Browilis/Arduino-Interactive-IO-Project-/(commit log)

2026-08-06 Project 1: button debounce + LED state machine with UART and 16x2 LCD output
2026-08-17 README: remove draft placeholders, tighten debugging writeup
2026-08-18 README: add wiring photo of the running system (LCD showing LED: BLINK)
